UHF-team/Smart-Car-Parking-using-UHF/ESP32_M6E-NANO/Arduino_Nano.odt

Connecting RFID Simultaneous reader with Arduino or ESP32

# 1.0 Background

To connect a SparkFun Simultaneous RFID Reader - M6E Nano (SEN-14066) to an application running on Linux or Windows (like the Universal Reader Assistant or URA) you need a separate USB to Serial converter. I wondered why an Arduino or ESP32 Thing could not be used as many people tried that (including me) and failed.

First the good news after analyzing and testing: it CAN be used. ! BUT you need to follow some steps in order to achieve that.

In this document I will explain the reasons and different options to apply.

Kind regards,

Paul van Haastrecht

paulvha@hotmail.com

# 2.0 What is the root cause for failure ?

## 2.1 Failure flow

The Arduino will reset based on a reset pulse, which is generated from the DTR signal of the USB OR at power-on OR pressing the reset-button. The DTR signal from the USB is causing a reset every time the USB port is opened.

This reset will start the bootloader which will check for a certain time (typically 500ms to 1 second) for any incoming data on the serial line. If received it will try to start the protocol to load a new sketch in flash memory. If not received, it will timeout and start the program that is already in flash (if any)

A problem with the URA (and other applications) is that they do not wait for the 1 second after opening the port, but start sending immediately. This will cause the bootloader to think it is getting a new program to load. Only after NOT getting valid protocol data and MAX_TIME_OUT after the last character received, it will start the program in flash. (if any)

## 2.2 Bootloader

I am not an expert on bootloaders, but have been reading a lot about it as well as study the source code. I have tested with an MEGA2560, with an STK500V2 bootloader. The nice aspect with the Mega2560 is that I can connect another serial debug monitor and can check how the program is behaving (not the bootloader !).

The STK500V2 bootloader has an initial time-out of about 1 second. When I used the test program I was able to detect the same timing. If any character received within the 1 second it will loop to get the full command. During that get_command_loop it will call recchar_timeout(). When a character is received within MAX_TIME_COUNT (defined as (F_CPU >> 1)) it will return that character, if however it exceeds MAX_TIME_OUT it will start the program in flash (if any)

## 2.3 Connecting to URA

During my test I connected a scope and the first message (requesting version info) is sent after 4ms.

After 100ms this is repeated. This is defined in the MercuryAPI as part of the OpenSerialPort() call, where it calls for CmdVersion() and the transport timeout is set.

The transport timeout is defined as : how long we expect the command itself to take (milliseconds).

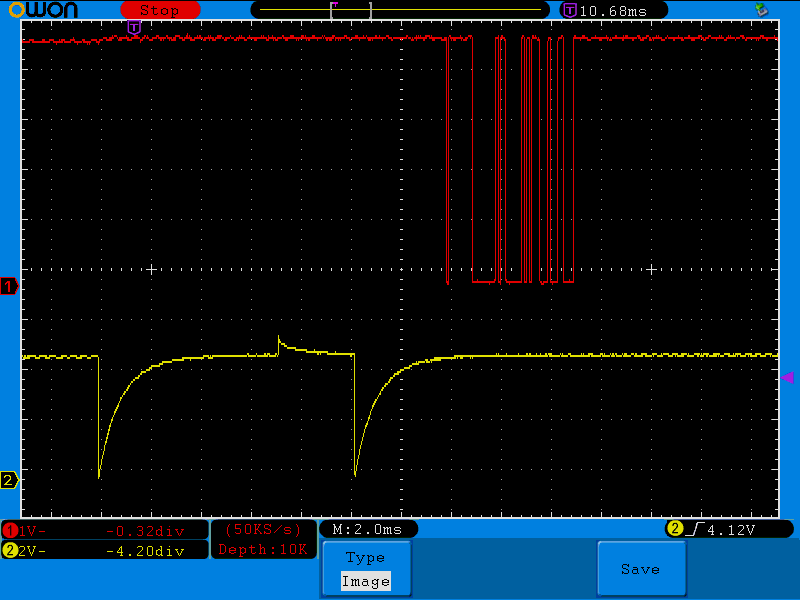
[picture p1: figure]

The DTR change creates a reset pulse to start the bootloader. Actually the URA is causing 2 pulses to happen on the MEGA2560. This is followed by the first request for version after (after 4ms), which is lost.

This picture shows the first connection attempt. In yellow the reset pulses, because of DTR, in red the request for version info, 4mS after reset.

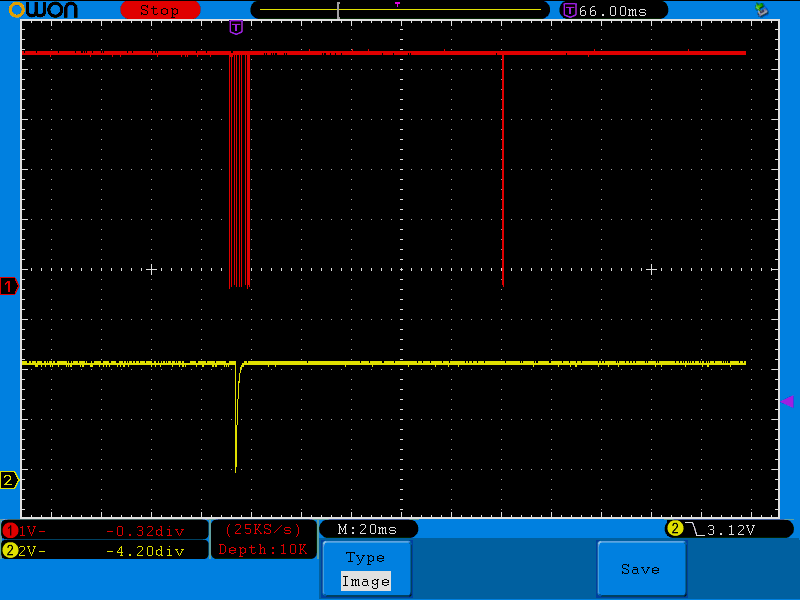
[picture p2: figure]

The bootloader is not ready. After 100mS the bootloader is ready and triggered: now the trouble starts.

This picture shows the second request after 100ms in red. On an Uno I only see 1 reset pulse.

The received information is not valid for bootloader, but the Arduino stays in bootloader trying to get valid data. The URA (and other MercuryAPI based applications) will repeat sending the version request every 100ms.

The MercuryAPI will try typically 9 times on different speeds : 9600, 9600, 115200, 921600, 19200, 38400, 57600, 230400, 460800. If not connected after 9 times the URA will give up and show an error message.

Now the bootloader will time-out and the program in flash is started.... but no URA looking for it.

## 2.4 validating test program

In order to prove the point, I have created a simple C-program (pulsetest.c) that I run on my Raspberry PI. I had to remove a number of error-checks and printf() statements in order to achieve the exact timing as the URA has.

With that I could replicate and demonstrate the points I am making above. I have tried to sent a completely different request than a version request, but the result is the same.

The URA actually sent 2 x DTR spike (so 2 times reset when opening for some reason) after each other within 10mS. I have simulated that, but there is no impact, the result is the same.

I then starting extending the time for the second message and discovered that this needs to be 1 second. (as defined in the STK500V2 source code)

# 3.0 What can be done to overcome?

Now that we know what the problem is, what can be done about this ?

1. Change the MercuaryAPI source code so it will wait for more than 1 second before trying to connect.
  1. A high level description on the changes needed are in chapter 5.0
2. Disable the RESET signal happening through software
  1. Use a GPIO to set RESET high (used in this sketch described in chapter 4.0)
  2. Adjust the High Fuse to ignore reset. Not recommended ! (see http://www.martyncurrey.com/arduino-atmega-328p-fuse-settings/ for some background)
3. Disable the RESET signal happening through hardware.
  1. On some boards there is a way to cut a link between DTR and RESET.
  2. Put a wire in between RESET and +5V

# 4.0 Sketch solution description

Instead (or next to) making a change in the MercuryAPI, a sketch has been created to handle the described issue. It has been tested on Arduino Uno, Mega2560 and ESP32 Thing. However it is not difficult to adjust for another platform. It has been tested against the (unmodified) URA, and DEMO. It does work !

## 4.1 High-level description

The sketch will initialize a local connection with a M6E Nano. If that is successful it can set and keep the RESET signal high, disabling that a DTR spike (because of a remote program opening the USB port). It will then read the data from the Serial/USB port, coming from a remote program and pass that on to the M6E Nano. The responds from the Nano will be sent to the serialUSB port and thus the remote program.

If the remote program sends a request to change the baudrate, this is intercepted and only the baudrate on the serial /USB connection is changed.

## 4.2 First some issues

Before you get too excited, organize a party and start to learn tap-dancing, some issues / concerns should be called out

1. softSerial and Nano must be at the same speed. The Nano will always be at 115K after reboot. That is too fast for softSerial to receive. During initialize we try connect with the lower speed. If that fails, we assume a reboot has happened: set softSerial to 115K and send a lower baudrate command and then reset softSerial to that lower baudrate. However if the Nano was not either the requested baudrate or 115K nothing will not connect.
2. softSerial has a default RX buffer of 64 characters. The chances of loosing characters due to buffer overrun is high. Keep reading Serial speed faster than the Nano to prevent buffer overrun as much as possible. That said you can increase the RX buffer in SoftSerial.h.
3. Next to the softSerial buffer, the Nano also has it's buffer and when in continuous mode I got errors with a Nano . That was not caused by softSerial but the Nano responding with rubbish. It seems that 38400 is a save speed to use on an Arduino. The ESP32 Thing was working stable on 19200.
4. Changing the serial baudrate by the remote program during setting and running the connection is not stable. The sketch will NOT change the Nano speed, but the speed of the serial connection. The Arduino needs time to change the baudrate (with a serial.begin() call) and the remote program might already be sending before that time has passed. During testing it worked sometime, but failed more often. It seems the URA is getting lost also as it would indicate the new requested speed of 38400, but continue to communicate on 115K. Set the CON_SPEED_SER to the same speed as the remote program wants to communicate and avoid baudrate changes as much as possible. Try to keep that to 115200.

That is it…!BUT make sure t read comments with Reset Blocker (4.3.7) !!!

## 4.3 Configuration

The sketch has a number of configurations that can be use to your needs. They will be explained below.

### 4.3.1 Enable Serial Debug

Optionally this sketch can provide debug messages on the Serial1. It has been tested with a Mega2560 and an ESP32 Thing from Sparkfun as they have multiple UART options. To enable remove the comments before : //#define SERIAL_DEBUG and read the hardware connection information in the document.(chapter 4.4)

### 4.3.2 M6E Nano connection

There are a number of ways to connect the M6E Nano:

If you connect on an Arduino ( UNO or MEGA2560 have been tested) the M6E Nano will be connected through SoftSerial. You can select your own pins by defining :

#define RFID_TX 12

#define RFID_RX 11

If you have an ESP32 Thing, the Serial2 will always be use (pin 16 and 17). See hardware connection below at chapter 4.4. The RFID_TX and RFID_RX are ignored. You have to remove the comments before to enable an ESP32:

//#define ESP32

### 4.3.3 Connection speeds

There are 3 speeds that can be configured:

#define CON_SPEED_NANO 38400

The speed with which the Nano is connected to your board. On an ESP32 the best is 19200, where on a Mega2560 & UNO best is 38400. But you can adjust it yourself.

#define CON_SPEED_SER 115200

This is the speed with the remote program. Actually the 115200 is the best.

#define CON_SPEED_DEBUG 115200

In case you have enabled a Serial debug connection (4.3.1) this defines the speed of that connection.

### 4.3.4 Receive buffer (optional)

The remote program request for the Nano will be saved in the receive buffer before passing-on to the Nano. 80 character is sufficient, but can be adjusted.

#define REC_BUF_SIZE 80

### 4.3.5 Check for remote request (optional)

If in continuous mode the Nano will keep on firing data. However the remote program may want to stop that. Hence after MAX_RESPONSE_COUNT messages in response of 1 request, it will check whether a new command from the remote program was received.

#define MAX_RESPONSE_COUNT 3

### 4.3.6 Settlement delay (optional)

If M6E Nano is powered with USB power, give the Nano time to settle. For my ESP32 this was necessary. The Arduino did not seem to have an issue. The value is in mS, thus 2000 = 2 second delay. If not necessary comment '//' out the line before #define WAIT_AFTER_POWER_ON 2000

#define WAIT_AFTER_POWER_ON 2000

### 4.3.7 Reset blocker

This is the core reason for the sketch. The first aspect… you do not always need Reset blocker. That is if you have either followed change in Chapter 5.1 OR you are using an ESP32.

Although the ESP32 suffered a bit from the issue. When the ESP32 was connected to Windows I got 3 x a reset. The URA had not started yet, so this must be the FTDI driver in Windows. After starting the URA and “connect”, another reset was coming (because of DTR change). After that any connect worked without problems from the URA

First you need to enable the reset-blocker software in the sketch

#define ENABLE_BLOCK_RESET

Now you need to define the GPIO pin that will be connect to RESET pin:

#define DISABLE_RESET_PIN 5

After successful local connection with Nano, the DISABLE_RESET_PIN will be pulled high. A program using the MerurcyAPI (like the URA) will always first send a version-request to the Nano for automatic baudrate detection. If received, the connection with the program works and the pin will be set as input. UNLESS you set :

#define KEEP_BLOCK_RESET

I advice to use the KEEP_BLOCK_RESET , because otherwise if you start the a program next time, the connection will fail and you have to reboot the Arduino/ESP32.

=======================================================================

WHILE RESET-BLOCKER IS ENABLED DO NOT RESET THE SYSTEM WITH THE RESET BUTTON AS THAT WILL CAUSE SHORT CIRCUIT AND DAMAGE TO ARDUINO OR ESP32.

!!!!!!!!!!!!! TO RESET: REMOVE AND RECONNECT THE POWER !!!!!!!!!!!

======================================================================

## 4.4 Hardware connection

### 4.4.1 Connected to an Arduino

Using lose wires to connect (switch on shield to HW-UART)

RFID shield Arduino

GND -------------- GND

NC (not connected)

VCC -------------- 5V

RX --------------- RFID_TX

TX --------------- RFID_RX

NC (not connected)

RESET <> DISABLE_RESET_PIN (For RESET BLOCKER)

EN (not connected)

****************

Putting the shield on top of ARDUINO (switch on shield to SW-UART)

RFID_RX 2

RFID_TX 3

RESET <> DISABLE_RESET_PIN (for RESET BLOCKER)

EN (not connected)

This will not work on an MEGA2560 as it does not have interrupts on pin 2.

### 4.4.2 Connected to ESP32 Thing Sparkfun

Set the onboard switch to HW-UART and connect with lose wires.

RFID reader ESP32 thing (Serial2 is used)

GND ----------------- GND

NC (not connected)

VCC ----------------- VUSB (OR external power)

UART TX ---- LS---- 16 (LS = level shifter !!)

UART RX ------------ 17

NC (not connected)

EN (not connected)

RESET <> DISABLE_RESET_PIN OPTIONAL

WARNING!! ESP32 !!WARNING!! ESP32 !!WARNING!! ESP32 !! WARNING!! ESP32 !!

The NANO M6E needs at least 3.7V VCC. It will not work stable on 3.3V.

As you connect to the 5V (VUSB or external) you MUST use a level shifter for the for RX line from RFID reader to the ESP32. The pins on the ESP-32 can only handle 3V3 signals !!

The RFID RX line, TX / pin 17 from ESP32, actually does not need a level shifter. The 3V3 that is coming from the ESP32 works good for the Nano. HOWEVER for the TX FROM the Nano, did not work well with that level shifter (https://www.sparkfun.com/products/12009)

Apparently the level shifter on the Nano and this level shifter do not work well together. So I made it working with resistors:

______ _____

GND ------| 10K |-----!---- | 5k6 |------ TX from Nano

-------- ! -------

!

pin 16 (ESP32)

## 4.5 Sketch functions

During setup() it will initialize the different requested serial ports and pins. It will call setupNano() to connect the M6E Nano locally. If successful it will turn on the LED, if failure it will blink the LED.

In loop() it will first call read_from_serial() to check for a request from a remote program. It will return TRUE if a complete request was received which is then forwarded to the Nano. It will then check if there is any character from the Nano and if so call sent_to_serial() to sent that to the remote program. sent_to_serial() will return TRUE if a new response-header was received from the Nano and in that case check a counter against MAX_RESPONSE_COUNT.

read_from_serial() will try to read a single request in one call. It will use the length of the request to determine whether all was received. It will also check with the OPCODE is 0x03 (version request) or 0x06(change baudrate). In case of 0x3 the reset-blocker is disabling is handled. In case of change baudrate it will set ‘Speed_request’. Once a complete request has been received and ‘Speed_request’, the request is passed on to handle_speed_change() to change the serial port baudrate and not sent to the Nano.

handle_speed_change() will sent a response through sent_to_serial() to the remote program and if needed change the serial port baudrate.

sent_to_serial() will sent character for character to the remote program. It will detect whether the character is the start of a new response and return TRUE if so, or whether the 0xff is part of the data in the response.

Debug messages are displayed and handled in different routines.

## 4.6 Sketch usage

CONNECT THE HARDWARE ACCORDING TO THE HARDWARE SECTION

MAKE SURE TO SET THE PARAMETERS CORRECT

DISCONNECT THE WIRE BETWEEN RESET AND THE DISABLE_RESET_PIN.(if any)

COMPILE AND UPLOAD THE SKETCH

RECONNECT THE WIRE BETWEEN RESET AND THE DISABLE_RESET_PIN. (if wanted)

ALWAYS WAIT AFTER THE POWER-ON TO CONNECT THE REMOTE PROGRAM

The on-board LED will blink after applying power and should within 15 seconds lid up stable. Now you are good to go! On failure to connect and initialize the Nano after 10 - 15 seconds on-board led will blink every second.

NOTE 1:

You can NOT just connect on pin 0 and 1 (the standard serial). Even with an empty sketch the driver on the Arduino will trigger interrupt with each character.

NOTE 2:

Always make sure to power the RFID shield with a good power supply. Many communication failures come from that as well.

NOTE 3:

You will need the right driver on the remote system (Windows, Linux etc) to communicate with your Arduino/ ESP32

NOTE 4:

If you use the RESET BLOCKER and want to upload a new sketch, you have to do that before the sketch has connected successfully with the Nano. Otherwise the reset will be blocked and the bootloader will not be started. You can also temporary remove the wire between RESET and DISABLE_RESET_PIN.

NOTE 5:

This sketch has been tested against the standard demo.c, URA from Jadak (current and older versions).

To use 'demo' on Windows from the samples directory :

start cmd

go to demo directory in the mercury API

demo tmr:///COM4 shell // or other valid COM-port to start interactive

>>> set /reader/read/plan SimpleReadPlan:[TagProtocol:GEN2,[1]] // enable GEN2 and antenna 1

>>> read // will read tags for 1 second and and display

>>> help set // will provide help information

To use 'URA' on Windows : select antenna 1, read/write power to max 5DB (if on VUSB)

# 5.0 Changes to Mercury API

In this chapter 3 optional changes are described:

1. change the OpenSerialPort() routine
2. change to wait after the baudrate change
3. change the API version number

In this chapter there is a high level description of the changes needed. It is assumed you know how to work with Visual Studio. I have made applied these changes successfully.

## 5.1 Changes in MercuryAPI to wait after opening the port

IF any change is to be considered and done : it is this one. !

With Visual Studio (2015 at least)

Open in the directory : .....MercuryAPi-version/cs/MercuryAPI.sln

You might get some error messages that it is not able to handle CE or preBonjour()... let Visual Studio correct.

In Visual Studio : solution explorer window

Open SerialReader.cs

Open SerialReader

select : OpenSerialPort(string, ref int) // in my version it is around line 3241

after

if (!_serialPort.IsOpen)

{

_serialPort.PortName = comPort;

_serialPort.WriteTimeout = 5000;

OnLog("Opening serial port " + _serialPort.PortName + "...");

_serialPort.Open();

OnLog("Opened serial port " + _serialPort.PortName);

}

insert the following:

// wait for 10 seconds for an Arduino

Thread.Sleep(10000);

Save the changes (File -> save SerialReader.cs)

Version 1.01 : The original time was 2 seconds, which is enough for the Bootloader, however the sketch needs to restart and reconnect to the Nano reader. This can take in total between 5 to 7 seconds. Have set for 10 seconds, just to be save, but if you apply you can try to reduce the time to what is needed for your board/sensor.

## 5.2 Changes to wait after requesting a baudrate change

Changing the baudrate during a session with the Arduino is not stable. This change will increase the stability, but still it still failed with the URA.

With Visual Studio (2015 atleast)

Open in the directory : .....MercuryAPi-version/cs/MercuryAPI.sln

You might get some error messages that it is not able to handle CE or preBonjour()... let Visual Studio correct.

In Visual Studio : solution explorer window

Open SerialReader.cs

Open SerialReader

select : ChangeBaudRate(int rate) in my version it is around line 3221

after

if (_serialPort.BaudRate != 0)

CmdSetBaudRate((uint)rate);

insert

// wait for 1 second

Thread.Sleep(1000);

before

SetSerialBaudRate(rate);

Save the changes (File -> save SerialReader.cs)

## 5.3 Change version number

Now this is a quick (and dirty) way to recognize that the DLL with the applied changes is used with the URA. Normally a new version is new Guid.

you can change in .....MercuryAPi-version/cs/ThingMagic.reader/properties/assemblyinfo.cs

In Visual Studio : solution explorer window

Open properties

Open assemblyinfo.cs

Change (in my version it is around line 34)

[assembly: AssemblyVersion("1.31.2.40")]

[assembly: AssemblyFileVersion("1.31.2.40")]

to (as example change the 40 to 41)

[assembly: AssemblyVersion("1.31.2.41")]

[assembly: AssemblyFileVersion("1.31.2.41")]

Save the changes (File -> save assemblyinfo.cs)

## 5.4 Rebuild the DLL

After applying and saving the changes , you now (re) build the DLL.

In visual studio : set for release in heading and select Build, build solution

You find a new version in .....MercuryAPi-version/cs/

Just in case you may want to create a backup copy of the original before build.

## 5.5 Rebuild application (URA)

Now you need to rebuild your application. I'll use the URA for example.

With Visual Studio (2015 atleast)

Open in the directory : .....MercuryAPi-version/cs/Samples/UniversalReaderAssistant2.0/UniversalReaderAssistant2.0.sln

You might get some error messages that it is not able to handle CE or preBonjour()... let Visual Studio correct.

In Visual Studio :

solution explorer window : select UniversalReaderAssistant2.0

Now (re) build the solution.

In Visual Studio : set for release in heading and select Build, build solution

The updated solution is in .....MercuryAPi-version/cs/Samples/UniversalReaderAssistant2.0/UniversalReaderAssistant2.0/bin/release/

Just in case you may want to create a backup copy of the original before build.

If you start the URA from that location and get to the main screen, select Reader Diagnostics and you will see Mercury API Version : 1.31.2.41 (if you changed to that).

Now connecting to an Arduino will work (2 seconds delay), changing baudrate is better.. but was not 100% yet.

M6E connect to Arduino/ESP32 page 14 of 14 Version 1.01 / March 2020
