UHF-team/Smart-Car-Parking-using-UHF/(commit log)

2022-09-27 Add LoRaSender ESP32_M6E-nano
2022-09-27 Update LoRaSender and ESP32_M6E-NANO code.
2022-09-27 Update LoRa and ESP32_M6E-NANO code.
2022-09-27 Update changes to ESP32_M6E-NANO.
2022-09-27 MOdified ESP32_M6E-NANO fix lastPackage
    [ESP32_M6E-NANO.ino]
2022-10-04 add print LoRaPackage and modify TagSimulator
2022-10-04 Modify ESP32_M6E-NANO fix isTheSame
    [ESP32_M6E-NANO.ino]
